dylanballback/CubeSat_Attitude_Control/README.md

# CubeSat Attitude Control Testbed
### Goals
Development of a 1U CubeSat Reaction Wheel Attitude Control Testbed that can be acessed through a website where anyone can upload code for tesing their control algorithm and view a live stream of their controls algorithm on hardware in real time.

---

# Major Milestones
### Controls of Reaction Wheel
| Milestone | Date Completed |
| --- | ---
| Create 1 DoF with 1 reaction wheel able to balance itself using a PID controller | 
| Create 2 DoF with 2 reaction wheels able to balance itself using a PID controller | 
| Create 3 DoF with 3 reaction wheels able to balance itself using a PID controller | 
| Create a 3 DoF reaction wheel controller able to reach any desired attitude using a PID controller |

### CubeSat Hardware
| Milestone | Date Completed |
| --- | ---
| Prototype CAD Assembly of 1U CubeSat with 3 Reaction wheels, IMU, Arduino, Raspberry Pi Zero, and Battery | 
| 3D print and assemble prototype 1U CubeSat will all componets mounted inside |
| Final CAD Assembly of 1U CubeSat with 3 Reaction wheels, IMU, Arduino, Raspberry Pi Zero, and Battery |
| 3D print and assemble final 1U CubeSat will all componets mounted inside | 

### Gimbal/Test Stand
| Milestone | Date Completed |
| --- | ---
| Prototype CAD Assembly of all three gimbal rings with mounting mounts to eachother and to the CubeSat | 
| 3D print prototype and assemble all 3 gimbal rings | 
| Attaching Gimbal test stand to 80/20 mounting frame |
| Final CAD Assembly of all three gimbal rings with mounting mounts to eachother and to the CubeSat |  

### Software
| Milestone | Date Completed |
| --- | ---
| All Arduino functions complete and rigiously tested |
| All Raspberry Pi functions complete and rigiously tested | 
| Raspberry Pi connected to webserver and able to upload code wirelessly |

### Integration 
| Milestone | Date Completed |
| --- | ---
| Attaching 1U CubeSat into gimbal rings  |
| Uploading code through website successfully  |

### Research Paper 
| Milestone | Date Completed |
| --- | ---
| Create Outline |
| Complete Rough Draft |
| Complete Final Version |
| Publish Research Paper |

---

# Schedule
| Due By Date | Milestone | Completed | Class Assignment
--- | --- | --- | ---
| 2/13/22 | ~~Project Proposal~~ | 2/13/22 | Yes
| 2/27/22 | 1 DoF reaction wheel balance with PID |   |
| 2/27/22 | Prototype CAD assembly of 1U CubeSat |   |
| 2/27/22 | Prototype CAD assembly of Gimbal testbed |   |
| 2/27/22 | Research Paper Outline | 
| 2/27/22 | Research Reduction |   | Yes
| 3/14/22 | 3D Print prototype 1U CubeSat and assemble  |    | 
| 3/14/22 | 3D Print prototype gimbal and assemble  |    |
| 3/14/22 | All Arduino functions complete and rigiously tested  |    |
| 3/14/22 | 2 DoF reaction wheel balance PID  |    |
| 3/21/22 | All Raspberry Pi functions complete and rigiously tested |    |
| 3/21/22 | Reserch paper rough draft |    |
| 3/21/22 | Project Update |    | Yes
| 4/10/22 | 3 DoF reaction wheel balance PID|    |
| 4/10/22 | Final CAD assembly of 1U CubeSat  |    |
| 4/10/22 | Prototype CAD assembly of gimbal testbed |    |
| 3/17/22 | 3D Print final 1U CubeSat and assemble  |    | 
| 3/17/22 | 3D Print final gimbal and assemble  |    |
| 4/17/22 | 1U CubeSat mounted in Gimbal |    |
| 4/24/22 | Wireless code upload |    |
| 4/24/22 | Research Paper Final Version |    |
| 5/1/22 | 3 DoF Attitude PID Controller |   | 
| 5/1/22 | Project Presentation |   | Yes
| 5/2/22 | Publish Research Paper |   | 
| 5/2/22 | Project Technical Paper |   | Yes

---

# Budget
| Item | Description | Link | Quantity | Cost/Item | Total Cost
--- | --- | --- | --- | --- | ---
| BLDC Motor | Reaction wheel motor | [Link](https://www.ebay.com/itm/264321073124) | 3 | $20 | $60
| MPU 6050 | IMU Sensor | [Link](https://www.amazon.com/HiLetgo-MPU-6050-Accelerometer-Gyroscope-Converter/dp/B01DK83ZYQ?th=1) | 1 | $6 | $6
| Photoresistor | Mock "Solar Sensor" | [Link](https://www.adafruit.com/product/161) | 6 | $1 | $6
| Raspberry Pi Zero 2 W | Mini Computer | [Link](https://www.canakit.com/raspberry-pi-zero-2-w.html) | 1 | $15 | $15
| Arduino Nano | Microcontroller | [Link](https://www.amazon.com/ELEGOO-Arduino-ATmega328P-Without-Compatible/dp/B0713XK923) | 1 | $8 | $8
| PLA | 3D printer material | [Link](https://www.amazon.com/HATCHBOX-3D-Filament-Dimensional-Accuracy/dp/B00J0ECR5I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) | 1 | $22 | $22
| Low Friction Bearings | Gimbal bearings | [Link](https://www.amazon.com/s?k=Low+Friction+Bearings&rh=n%3A16410991&ref=nb_sb_noss) | 10 | $1 | $10
| Batteries | 18650 cells | [Link](https://www.18650batterystore.com/) | 6 | $5 | $30
| Battery Management System | Protect batteries | Custom | 1 | $15 | $15
| | | | | | $172
