dylanballback/CubeSat_Attitude_Control/Hardware/Gimbal Hardware/README.md

# Gimbal test bed stand for CubeSat Hardware

## Goals
The goal of the gimbal is to design and build a system that a 1U CubeSat mounts inside and provide free rotations in 3 degrees of freedom. This test stand gimbal will allow for the 1U CubeSat to freely rotate in all 3 DoF for testing the attitude control using 3 reaction wheels.

## To-Do

### Gimbal CAD
| Declared | To-Do | Completed |
--- | --- | ---
| 2/8/22 | ~Design mounting mechanism to attach the 1U CubeSat to the inner ring~ | 2/20/22
| 2/8/22 | ~3D print and test fitment of CubeSat connection to inner ring~ | 2/20/22
| 2/8/22 | ~Calculate and design the 3 gimbal rings~ | 2/20/22
| 2/8/22 | ~3D print and test fitment of the 3 rings and connection~ | 2/26/22
| 2/8/22 | ~Test fitment of bearing componets into 3D printed ring and connection between the rings~ | 2/26/22
| 2/8/22 | ~Design outter ring external mounting points to be compatiable to monut to a 80/20 test stand~ | 2/27/22
| 2/8/22 | ~Build 80/20 Gimbal Test stand~ | 2/27/22
| 2/8/22 | ~Assembly and mount all componets of the gimbal and cubesat into the test stand~ | 2/27/22
| 2/8/22 | Optimize ring componet fitment and connections |

### Gimbal Hardware
| Declared | To-Do | Completed |
--- | --- | ---
| 2/8/22 | Figure out the best bearings for the gimbal to allow for low friction rotation |

## Updates 

### 2/20/22
- Designed prototype gimbal rings.
<p>
    
</p>

---

### 2/26/22
- 3D printed prototype gimbal ring, testing bearings and fitment of componets and connectors.
<p>
    
    
</p>

---

### 2/27/22
- Designed and built CubeSat gimbal teststand, and 3D printed peices.
<p float="center">
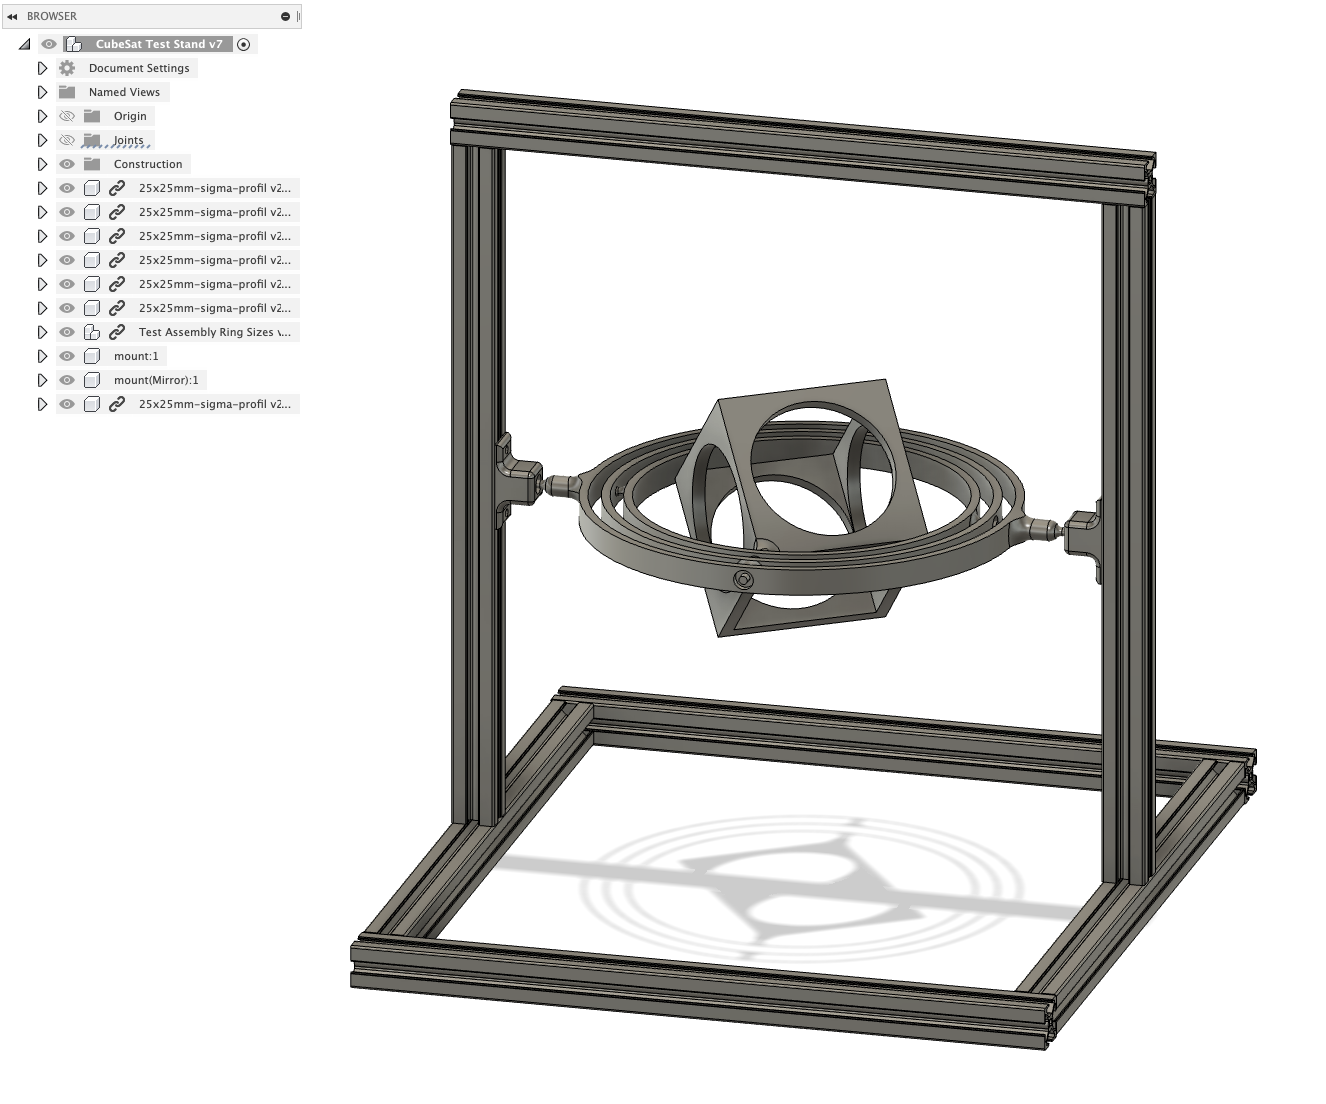
[picture p15: Images/cubesat_hardware/cubesat_testbed_v1cad.png]
    
</p>
<p float="left">
    
    
</p>

---

### 2/28/22 
- Optmizing CAD for press fitment of the bearings and ring connections

<p>
    
</p>

---

### 3/3/22 
- Updated gimbal mounts to CubeSat frame using threaded inserts on the side frame of the CubeSat instead previously where I was mounting it from corners. Using this method will allow for the CubeSat frame itself will be easier to 3D print and rapidly iterated upon and not require new print everytime to mount to the gimbal. 

<p>
    
    
    
    
</p>

---

### 3/4/22
- Designed and 3D printed a gimbal lock piece that snaps in place to lock the gimbal rings in place, this will allow for me to test the reaction wheel PID control of just a single axis in the gimbal mount. 

<p>
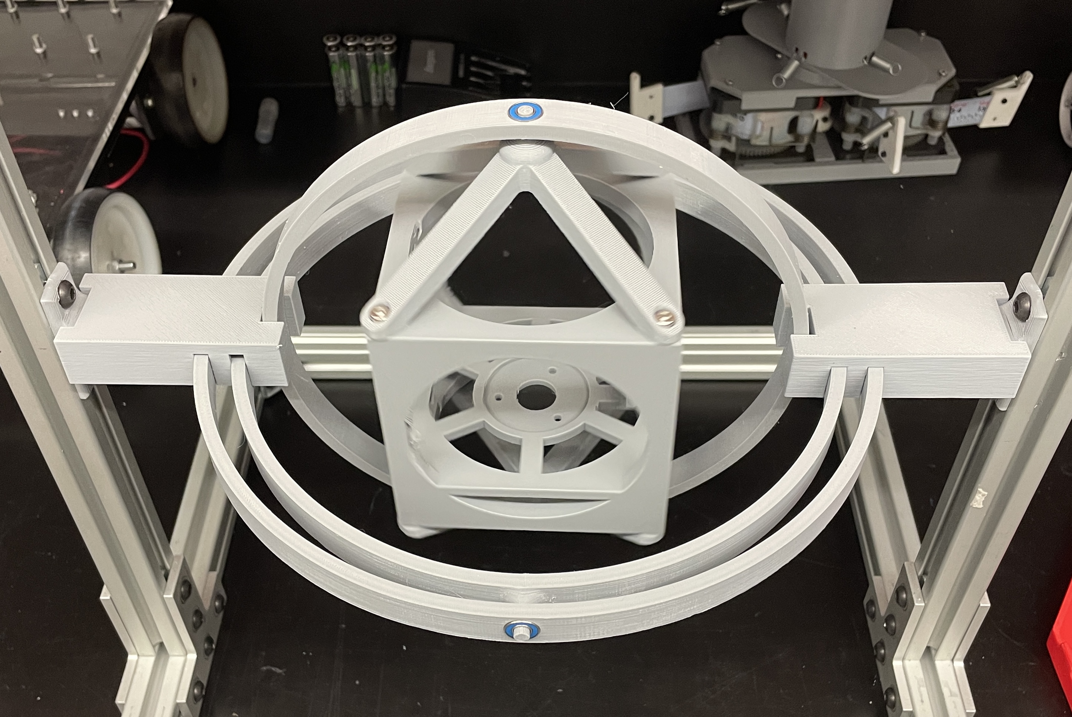
[picture p19: Images/cubesat_hardware/front_1dof_gimballock.JPG]
    
    
    
</p>
