dylanballback/CubeSat_Attitude_Control/Software/Wireless Communincation/Raspberry Pi & Arduino Com/Serial Communication/README.md

# Serial communication between Arduino and Computer

This is a simple test of how to recive usable data from serial in python from an Arduino 

- The arduino code is just printing to serial monitor
- The python code is reading the serial data and decoding it to print as a string
