dylanballback/CubeSat_Attitude_Control/Papers and Posters/Discovery_Day_Poster_4_6_22.pptx

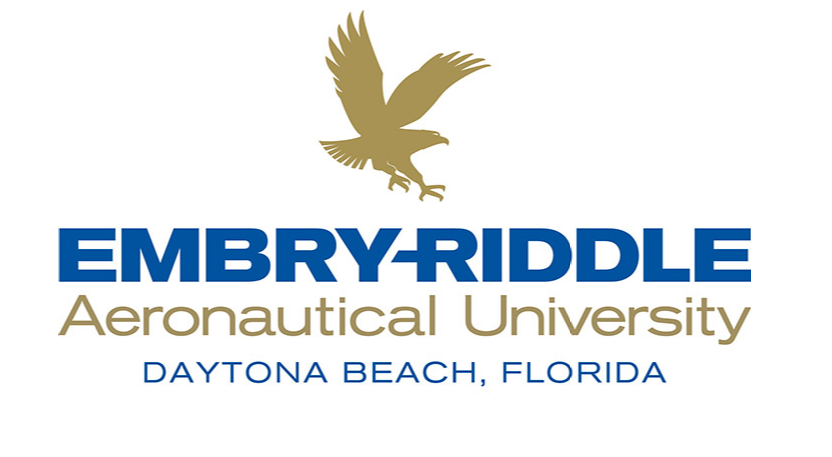
[picture p23: figure]

CubeSat Reaction Wheel
Attitude Control Platform

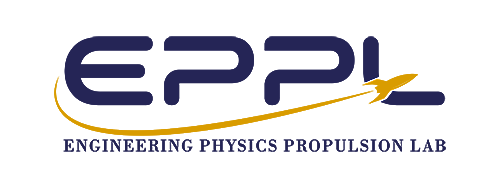
[picture p24: figure]
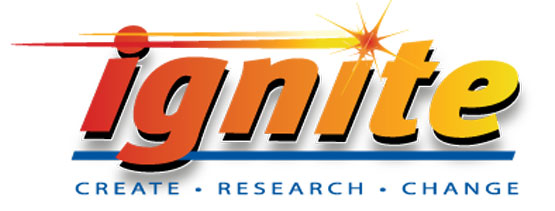
[picture p25: figure]

Dylan Ballback, Daniel Wilczak, Justin Hartland, Ella Cheatham, Daniel Golan

Abstract

- In the classroom, learning the math behind spacecraft attitude control is math-intensive. It is common that students struggle to develop the connection between the math they are learning and visualizing how it could be applied to a real-world application.
- The goal of this project is to design and manufacture a 1U, 3U, 6U CubeSat testbed for autonomous control systems utilizing reaction wheels. The testbed will include three separate reaction wheels each mounted on its own respected axis of the rotation plane to control the attitude in 3 degrees of freedom.
- The end goal of the CubeSat testbed is to be integrated into a website where anyone online can upload their own controls algorithm and watch a live stream of how their algorithm performs on hardware in real-time.

Significance

1. The current process to learn CubeSat controls is vastly conceptual for students from the high school, undergraduate, and even graduate levels.
2. Building a testbed in a gimbal connected to the internet would allow students the opportunity to test their designs, theories, and software on real CubeSat hardware in real-time.
3. A use case for the testbed would be to integrate into the classroom while learning the math behind attitude controls.

- Project Goals

- Develop a 1U, 3U, and 6U CubeSat Reaction Wheel Attitude Control Platform.
- Integrate CubeSat control into a website to allow anyone to upload their own control algorithm and watch a live stream to evaluate how it performs.

- Current State

- Prototype 1U CubeSat 3D printed and assembled.
- Designed and assembled 1U CubeSat gimbal rings and test stand.
- Achieved simple 1 degree of freedom PID controller.
- Accomplished basic WebSocket wireless communication infrastructure between the CubeSat and a website to live stream data in real-time and send data from website.

CubeSat attitude control is to enable the CubeSat to point in the desired direction that is set in relation to a reference frame.

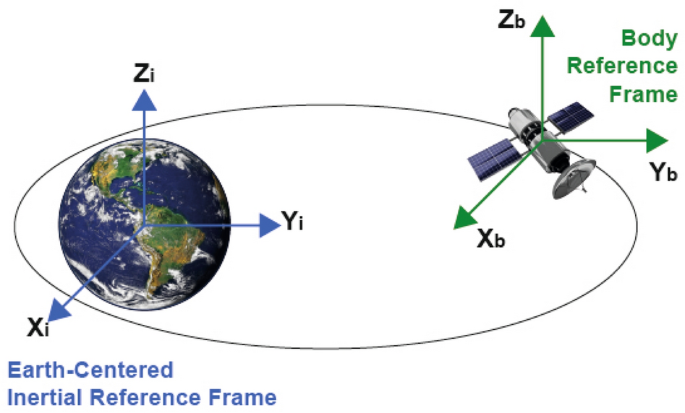
[picture p26: figure]
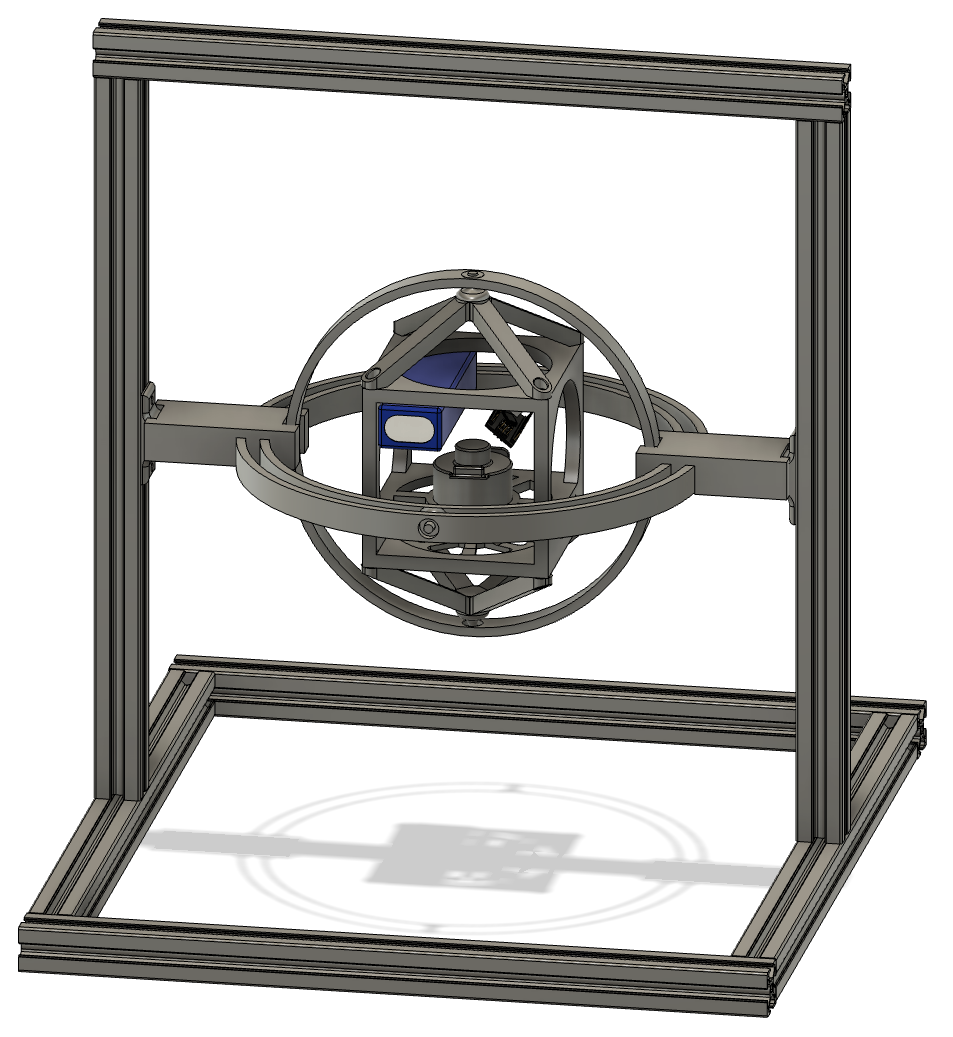
[picture p27: figure]
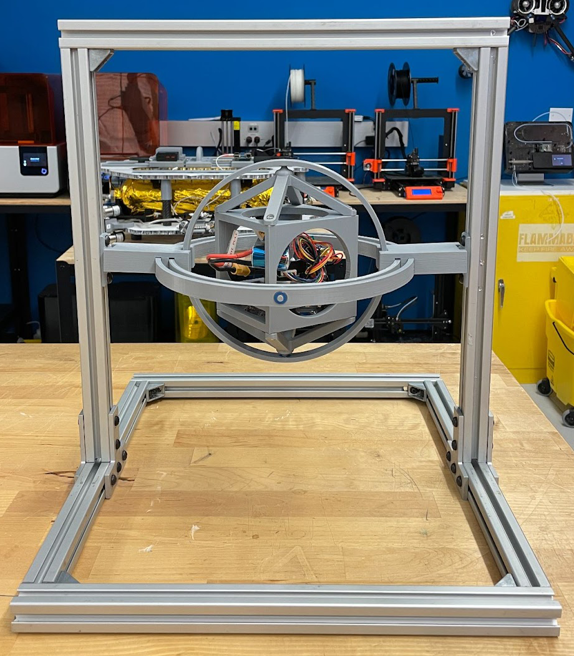
[picture p28: figure]
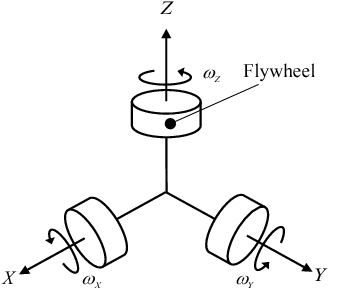
[picture p29: figure]

- Methodology

- Design and 3D print a 1U, 3U, and 6U CubeSat test bed.
- Design and 3D print the 1U, 3U, and 6U gimbal ring assembly to allow for free rotation in 3 degrees of freedom.
- Design and fabricate extruded aluminum test stand to hold gimbal and CubeSat assembly for 1U, 3U, and 6U CubeSat.
- Develop the electronics/software to control reaction wheel motors and read IMU and motor encoder sensors.
- Develop software infrastructure for wireless communication between website and CubeSat.
- Develop example PID controller to control CubeSat attitude.

Moving Forward

- Working on design and 3D printing of the first prototype of the 3U and 6U CubeSat for 1 DOF control testing.
- Developing design and assembly for 3U and 6U CubeSat gimbal rings and test stand.

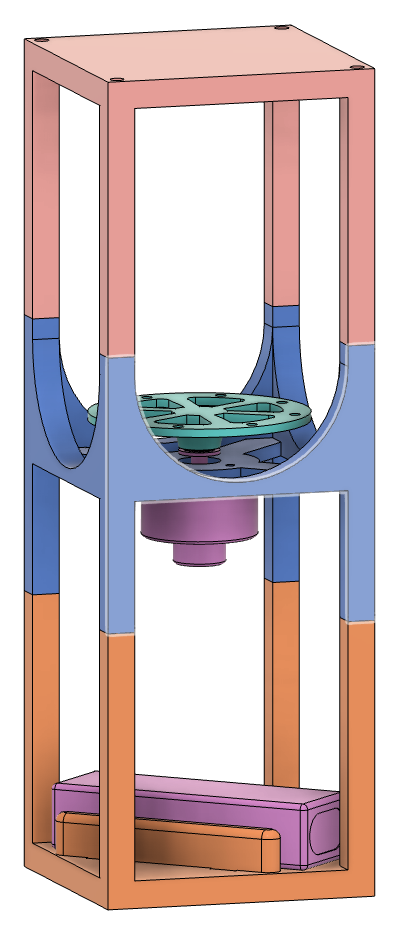
[picture p30: figure]

3U CubeSat CAD Prototype

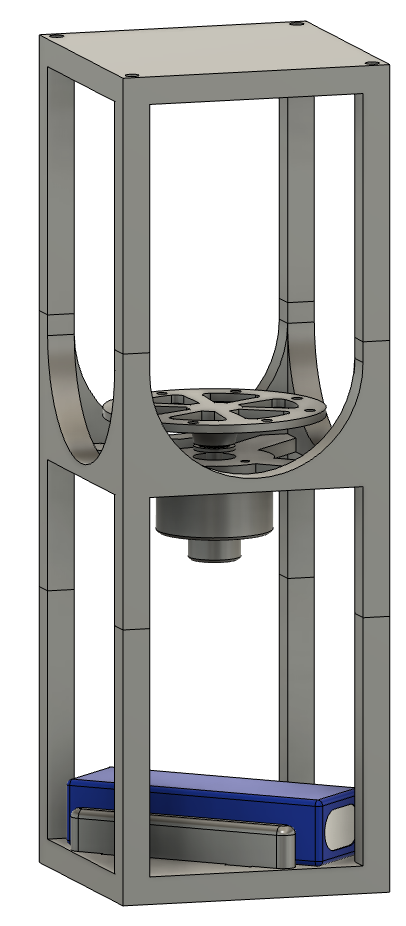
[picture p31: figure]
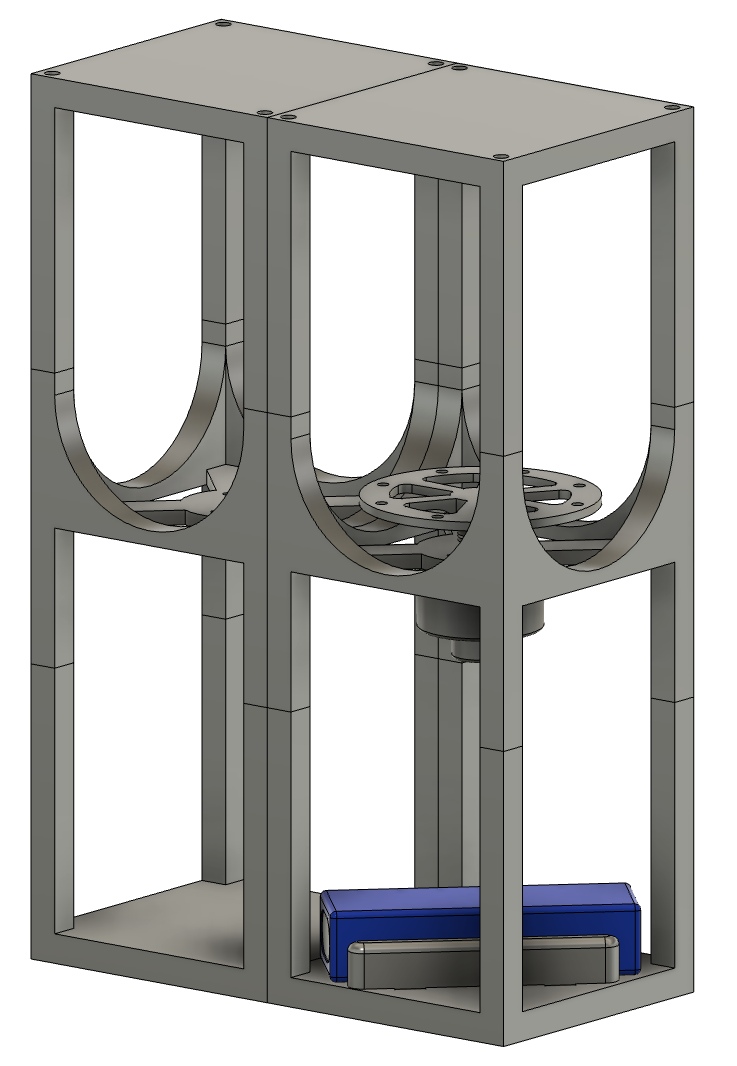
[picture p32: figure]

6U CubeSat CAD Prototype

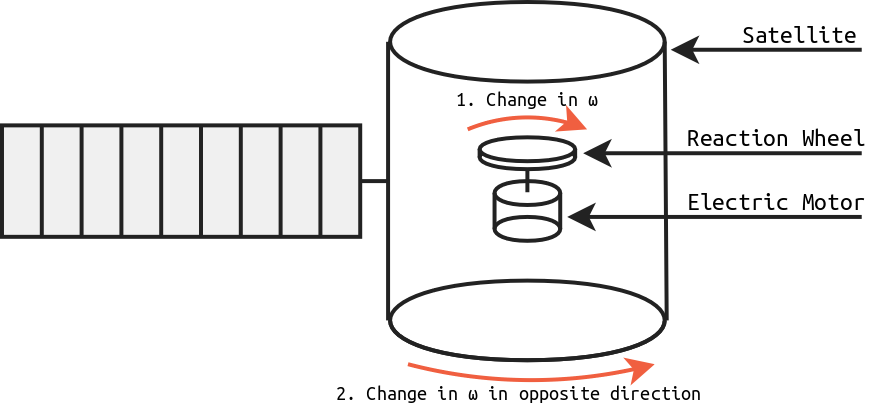
[picture p33: figure]
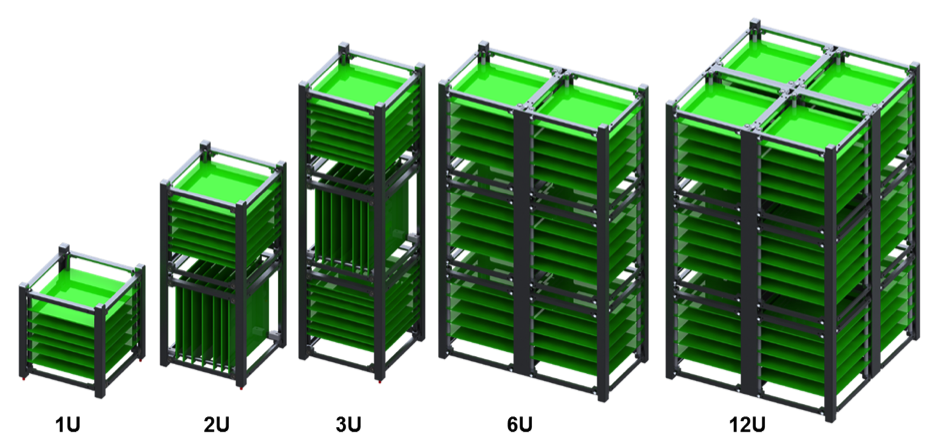
[picture p34: figure]

Notes: To change this poster, replace our sample content with your own. Or, if you'd rather start from a clean slate, use the New Slide button on the Home tab to insert a new page, then enter your text and content in the empty placeholders. If you need more placeholders for titles, subtitles or body text, copy any of the existing placeholders, then drag the new one into place.
