dylanballback/CubeSat_Attitude_Control/Images/CubeSat_control_PCB2022-04-10 at 11.04.40 PM.png

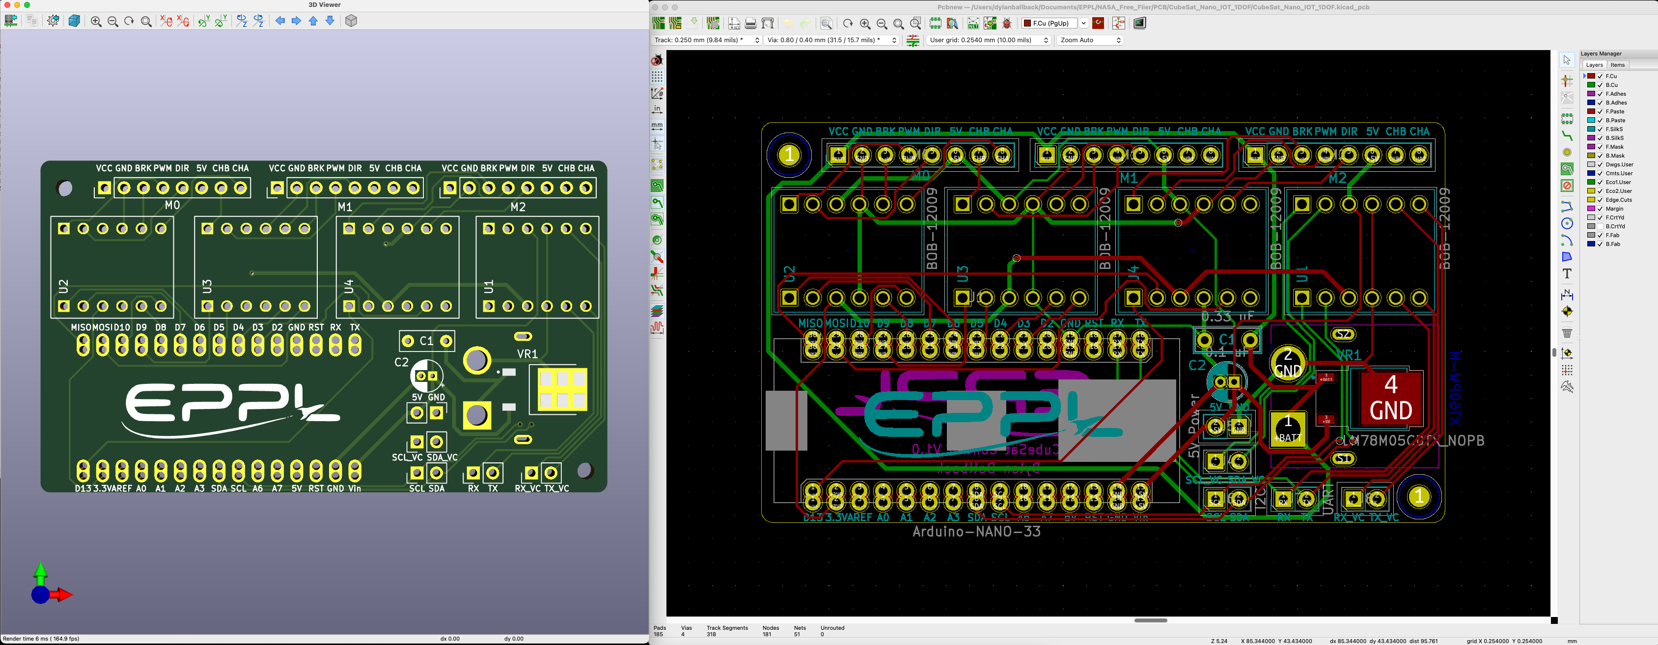
Images/CubeSat_control_PCB2022-04-10 at 11.04.40 PM.png
