dylanballback/CubeSat_Attitude_Control/(list of files, cad)

Other CAD files:
Hardware/Gimbal Hardware/Gimbal CAD V1/1U CubeSat v5.ipt
