dylanballback/CubeSat_Attitude_Control/1DoF Prototype/Arduino/balance_V14/balance_V14.ino

#include <Kalman.h> // Source: https://github.com/TKJElectronics/KalmanFilter
#include <Wire.h>        // IIC communication library
#include <PWM.h>        // Require Timer1 PWM frequency of 20Khz-25Khz for Nidec 24H677 BLDC Motor
#include "QuickPID.h"

//Cite http://brettbeauregard.com/blog/2011/04/improving-the-beginner%E2%80%99s-pid-reset-windup/)

//---------------------------------------- Nidec 24H677H010 BLDC Motor Vars START ------------------------------------
const int nidecBrake = 8;      // Brake
const int nidecDirection = 7;  // CW/CCW Nidec Motor
const int ledsDirection = 6;   // Green LED direction indicators
const int ledsBrake = 5;       // Red LED direction indicators
const int nidecPWM = 9;        // Nidec Motor PWM
int brake_trigger = 1;         //Brake is ON
int dir = 0;                   //Direction set to CCW
double pwm = 400;              // Set pwm value to 400 = motor stopped
//---------------------------------------- Nidec 24H677H010 BLDC Motor Vars END --------------------------------------


//---------------------------------------- Kalman Filter START -------------------------------------------------------
#define RESTRICT_PITCH // Comment out to restrict roll to ±90deg instead - please read: http://www.freescale.com/files/sensors/doc/app_note/AN3461.pdf

Kalman kalmanX; // Create the Kalman instances
Kalman kalmanY;

/* IMU Data */
double accX, accY, accZ;
double gyroX, gyroY, gyroZ;
int16_t tempRaw;

double gyroXangle, gyroYangle; // Angle calculate using the gyro only
double compAngleX, compAngleY; // Calculated angle using a complementary filter
double kalAngleX, kalAngleY; // Calculated angle using a Kalman filter

uint32_t timer;
uint8_t i2cData[14]; // Buffer for I2C data
//---------------------------------------- Kalman Filter END -------------------------------------------------------



//---------------------------------------- PID Vars START -------------------------------------------------------
/*
//PID constants
double kp = 10;
double ki = 0.05;
double kd = 0;

double outMin = -400;
double outMax = 400;


int term;
 
unsigned long currentTime, previousTime;
double elapsedTime;
double error;
double lastError;
double Input, Output, Setpoint;
double i, d;
*/
double bounds = 0.3;
//---------------------------------------- PID Vars END -----------------------------------------------------------
//Define Variables we'll be connecting to
float Setpoint, Input, Output;

//Define the aggressive and conservative and POn Tuning Parameters
float aggKp = 8, aggKi = 0.2, aggKd = 1;
float consKp = 2, consKi = 0.05, consKd = 0.5;

//Specify the links
QuickPID myPID(&Input, &Output, &Setpoint);



//%%%%%%%%%%%%%%%%%%%%%%%%%%%%%%%%%%%%%%%%%%%%%%%%%%%%%%%%%%%%%%%%%%%%%%%%%%%%%%%%%%%%%%%%%%%%%%%%%%%%%%%%%%%%%%%%%%%%%%
//%%%%%%%%%%%%%%%%%%%%%%%%%%%%%%%%%%%%%%%%%%%%%%%% Setup Function Start %%%%%%%%%%%%%%%%%%%%%%%%%%%%%%%%%%%%%%%%%%%%%%%%
//%%%%%%%%%%%%%%%%%%%%%%%%%%%%%%%%%%%%%%%%%%%%%%%%%%%%%%%%%%%%%%%%%%%%%%%%%%%%%%%%%%%%%%%%%%%%%%%%%%%%%%%%%%%%%%%%%%%%%%
void setup() {
  
  // PWM.h Setup
  InitTimersSafe();
  // The Nidec 24H677 BLDC Motor requires a PWM frequency of 20KHz to 25KHz
  bool success = SetPinFrequencySafe(nidecPWM, 20000);

  //set the Nidec motor control pins 
  pinMode(nidecBrake, OUTPUT);
  pinMode(nidecDirection,OUTPUT);
  pinMode(ledsDirection,OUTPUT);
  pinMode(ledsBrake,OUTPUT);
  pinMode(nidecPWM,OUTPUT);
  
  // Output initial state values
  digitalWrite(nidecDirection,LOW); // Nidec Direction CCW
  digitalWrite(ledsDirection,LOW); //Green LED OFF // Direction CCW
  digitalWrite(nidecBrake,LOW); // Nidec motor brake is ON
  digitalWrite(ledsBrake,HIGH); //Red LED ON // Brake ON

  
//---------------------------------------- Kalman Filter START -------------------------------------------------------
  Serial.begin(115200);
  Wire.begin();
  #if ARDUINO >= 157
    Wire.setClock(400000UL); // Set I2C frequency to 400kHz
  #else
    TWBR = ((F_CPU / 400000UL) - 16) / 2; // Set I2C frequency to 400kHz
  #endif

  i2cData[0] = 7; // Set the sample rate to 1000Hz - 8kHz/(7+1) = 1000Hz
  i2cData[1] = 0x00; // Disable FSYNC and set 260 Hz Acc filtering, 256 Hz Gyro filtering, 8 KHz sampling
  i2cData[2] = 0x00; // Set Gyro Full Scale Range to ±250deg/s
  i2cData[3] = 0x00; // Set Accelerometer Full Scale Range to ±2g
  while (i2cWrite(0x19, i2cData, 4, false)); // Write to all four registers at once
  while (i2cWrite(0x6B, 0x01, true)); // PLL with X axis gyroscope reference and disable sleep mode

  while (i2cRead(0x75, i2cData, 1));
  if (i2cData[0] != 0x68) { // Read "WHO_AM_I" register
    Serial.print(F("Error reading sensor"));
    while (1);
  }

  delay(100); // Wait for sensor to stabilize

  /* Set kalman and gyro starting angle */
  while (i2cRead(0x3B, i2cData, 6));
  accX = (int16_t)((i2cData[0] << 8) | i2cData[1]);
  accY = (int16_t)((i2cData[2] << 8) | i2cData[3]);
  accZ = (int16_t)((i2cData[4] << 8) | i2cData[5]);

  // Source: http://www.freescale.com/files/sensors/doc/app_note/AN3461.pdf eq. 25 and eq. 26
  // atan2 outputs the value of -π to π (radians) - see http://en.wikipedia.org/wiki/Atan2
  // It is then converted from radians to degrees
  #ifdef RESTRICT_PITCH // Eq. 25 and 26
    double roll  = atan2(accY, accZ) * RAD_TO_DEG;
    double pitch = atan(-accX / sqrt(accY * accY + accZ * accZ)) * RAD_TO_DEG;
  #else // Eq. 28 and 29
    double roll  = atan(accY / sqrt(accX * accX + accZ * accZ)) * RAD_TO_DEG;
    double pitch = atan2(-accX, accZ) * RAD_TO_DEG;
  #endif

  kalmanX.setAngle(roll); // Set starting angle
  kalmanY.setAngle(pitch);
  gyroXangle = roll;
  gyroYangle = pitch;
  compAngleX = roll;
  compAngleY = pitch;
//------------------------------------------------ Kalman Filter END --------------------------------------------------------
  myPID.SetOutputLimits(0, 400);
  Setpoint = 0;                          //set point at zero degrees
 //turn the PID on
  myPID.SetMode(myPID.Control::automatic);
}
//%%%%%%%%%%%%%%%%%%%%%%%%%%%%%%%%%%%%%%%%%%%%%%%%%%%%%%%%%%%%%%%%%%%%%%%%%%%%%%%%%%%%%%%%%%%%%%%%%%%%%%%%%%%%%%%%%%%%%%
//%%%%%%%%%%%%%%%%%%%%%%%%%%%%%%%%%%%%%%%%%%%%%% Setup Function END %%%%%%%%%%%%%%%%%%%%%%%%%%%%%%%%%%%%%%%%%%%%%%%%%%%%
//%%%%%%%%%%%%%%%%%%%%%%%%%%%%%%%%%%%%%%%%%%%%%%%%%%%%%%%%%%%%%%%%%%%%%%%%%%%%%%%%%%%%%%%%%%%%%%%%%%%%%%%%%%%%%%%%%%%%%%


//%%%%%%%%%%%%%%%%%%%%%%%%%%%%%%%%%%%%%%%%%%%%%%%%%%%%%%%%%%%%%%%%%%%%%%%%%%%%%%%%%%%%%%%%%%%%%%%%%%%%%%%%%%%%%%%%%%%%%%
//%%%%%%%%%%%%%%%%%%%%%%%%%%%%%%%%%%%%%%%%%%%%%% Loop Function START %%%%%%%%%%%%%%%%%%%%%%%%%%%%%%%%%%%%%%%%%%%%%%%%%%%
//%%%%%%%%%%%%%%%%%%%%%%%%%%%%%%%%%%%%%%%%%%%%%%%%%%%%%%%%%%%%%%%%%%%%%%%%%%%%%%%%%%%%%%%%%%%%%%%%%%%%%%%%%%%%%%%%%%%%%%
void loop() {
 
  double x_angle = kalman();

 
  Input = x_angle;


  /*
  //Calculate the PID output
  Output = computePID(Input, x_angle);
  
    //Switches the direction of the wheel based on sign of PID output
  if (Output > 1){
    dir = 1; //CW
    Output = map(Output, 0, outMax, 0, 400);
    //This is just fliping the PWM value from 0 to 390 ---> to 390 to 0
    //Whereas 0 = stopped and 390 = full speed
    pwm = map(Output, 0, outMax, 400, 0);
    //Serial.print("dir: ");
    //Serial.print("CW");
    //Serial.print("    ");
  }
  else if (Output < 0){
    dir = 0; //CCW
    Output = abs(Output);
    Output = map(Output, 0, outMin, 0, 400);
    //This is just fliping the PWM value from -390 to 0 ---> to 390 to 0
    //Whereas 0 = stopped and 390 = full speed
    pwm = map(Output, 0, outMin, 400, 0);
    //Serial.print("dir: ");
    //Serial.print("CCW");
    //Serial.print("    ");
  }
  */

  if (x_angle > -bounds && x_angle < bounds){
    pwm = 400;
  }


  float gap = abs(Setpoint - Input); //distance away from setpoint
  if (gap < 10) { //we're close to setpoint, use conservative tuning parameters
    myPID.SetTunings(consKp, consKi, consKd);
  } else {
    //we're far from setpoint, use aggressive tuning parameters
    myPID.SetTunings(aggKp, aggKi, aggKd);
  }
  myPID.Compute();
  pwm = map(Output, 0, 400, 400, 0);
  //This is the comand to drive the motor
  driveMotor(pwm, dir);
  Serial.println(pwm);
  

}//end of loop void
//%%%%%%%%%%%%%%%%%%%%%%%%%%%%%%%%%%%%%%%%%%%%%%%%%%%%%%%%%%%%%%%%%%%%%%%%%%%%%%%%%%%%%%%%%%%%%%%%%%%%%%%%%%%%%%%%%%%%%%
//%%%%%%%%%%%%%%%%%%%%%%%%%%%%%%%%%%%%%%%%%%%%%% Loop Function END %%%%%%%%%%%%%%%%%%%%%%%%%%%%%%%%%%%%%%%%%%%%%%%%%%%
//%%%%%%%%%%%%%%%%%%%%%%%%%%%%%%%%%%%%%%%%%%%%%%%%%%%%%%%%%%%%%%%%%%%%%%%%%%%%%%%%%%%%%%%%%%%%%%%%%%%%%%%%%%%%%%%%%%%%%%



//$$$$$$$$$$$$$$$$$$$$$$$$$$$$$$$$$$$$$$  Kalman Filter Function START $$$$$$$$$$$$$$$$$$$$$$$$$$$$$$$$$$$$$$
double kalman(){
  /* Update all the values */
  while (i2cRead(0x3B, i2cData, 14));
  accX = (int16_t)((i2cData[0] << 8) | i2cData[1]);
  accY = (int16_t)((i2cData[2] << 8) | i2cData[3]);
  accZ = (int16_t)((i2cData[4] << 8) | i2cData[5]);
  tempRaw = (int16_t)((i2cData[6] << 8) | i2cData[7]);
  gyroX = (int16_t)((i2cData[8] << 8) | i2cData[9]);
  gyroY = (int16_t)((i2cData[10] << 8) | i2cData[11]);
  gyroZ = (int16_t)((i2cData[12] << 8) | i2cData[13]);;

  double dt = (double)(micros() - timer) / 1000000; // Calculate delta time
  timer = micros();

  // Source: http://www.freescale.com/files/sensors/doc/app_note/AN3461.pdf eq. 25 and eq. 26
  // atan2 outputs the value of -π to π (radians) - see http://en.wikipedia.org/wiki/Atan2
  // It is then converted from radians to degrees
#ifdef RESTRICT_PITCH // Eq. 25 and 26
  double roll  = atan2(accY, accZ) * RAD_TO_DEG;
  double pitch = atan(-accX / sqrt(accY * accY + accZ * accZ)) * RAD_TO_DEG;
#else // Eq. 28 and 29
  double roll  = atan(accY / sqrt(accX * accX + accZ * accZ)) * RAD_TO_DEG;
  double pitch = atan2(-accX, accZ) * RAD_TO_DEG;
#endif

  double gyroXrate = gyroX / 131.0; // Convert to deg/s
  double gyroYrate = gyroY / 131.0; // Convert to deg/s

#ifdef RESTRICT_PITCH
  // This fixes the transition problem when the accelerometer angle jumps between -180 and 180 degrees
  if ((roll < -90 && kalAngleX > 90) || (roll > 90 && kalAngleX < -90)) {
    kalmanX.setAngle(roll);
    compAngleX = roll;
    kalAngleX = roll;
    gyroXangle = roll;
  } else
    kalAngleX = kalmanX.getAngle(roll, gyroXrate, dt); // Calculate the angle using a Kalman filter

  if (abs(kalAngleX) > 90)
    gyroYrate = -gyroYrate; // Invert rate, so it fits the restriced accelerometer reading
  kalAngleY = kalmanY.getAngle(pitch, gyroYrate, dt);
#else
  // This fixes the transition problem when the accelerometer angle jumps between -180 and 180 degrees
  if ((pitch < -90 && kalAngleY > 90) || (pitch > 90 && kalAngleY < -90)) {
    kalmanY.setAngle(pitch);
    compAngleY = pitch;
    kalAngleY = pitch;
    gyroYangle = pitch;
  } else
    kalAngleY = kalmanY.getAngle(pitch, gyroYrate, dt); // Calculate the angle using a Kalman filter

  if (abs(kalAngleY) > 90)
    gyroXrate = -gyroXrate; // Invert rate, so it fits the restriced accelerometer reading
  kalAngleX = kalmanX.getAngle(roll, gyroXrate, dt); // Calculate the angle using a Kalman filter
#endif

  gyroXangle += gyroXrate * dt; // Calculate gyro angle without any filter
  gyroYangle += gyroYrate * dt;
  //gyroXangle += kalmanX.getRate() * dt; // Calculate gyro angle using the unbiased rate
  //gyroYangle += kalmanY.getRate() * dt;

  compAngleX = 0.93 * (compAngleX + gyroXrate * dt) + 0.07 * roll; // Calculate the angle using a Complimentary filter
  compAngleY = 0.93 * (compAngleY + gyroYrate * dt) + 0.07 * pitch;

  // Reset the gyro angle when it has drifted too much
  if (gyroXangle < -180 || gyroXangle > 180)
    gyroXangle = kalAngleX;
  if (gyroYangle < -180 || gyroYangle > 180)
    gyroYangle = kalAngleY;
      
  //Serial.print(kalAngleX);
  //Serial.print('\n');
  return kalAngleX;
}
//$$$$$$$$$$$$$$$$$$$$$$$$$$$$$$$$$$$$$$  Kalman Filter Function END $$$$$$$$$$$$$$$$$$$$$$$$$$$$$$$$$$$$$$



//$$$$$$$$$$$$$$$$$$$$$$$$$$$$$$$$$$$$$$  Drive Motor Function START $$$$$$$$$$$$$$$$$$$$$$$$$$$$$$$$$$$$$$
// For pwm: 400 = stopped and 0 = full speed
// For dir: 0 = CCW and 1 = CW
void driveMotor(float pwm,int dir){
  //if pwm 
  digitalWrite(nidecBrake,HIGH);    // Nidec motor brake OFF
  digitalWrite(ledsBrake,LOW);      //Red LED OFF // Brake OFF
  if(dir == 0){
    analogWrite(nidecPWM, pwm);
    digitalWrite(nidecDirection,LOW); // Nidec Direction CCW
    digitalWrite(ledsDirection,LOW);  //Green LED OFF // Direction CCW
    }
  else if(dir == 1){
    analogWrite(nidecPWM, pwm);
    digitalWrite(nidecDirection,HIGH); // Nidec Direction CW
    digitalWrite(ledsDirection,HIGH);  //Green LED ON // Direction CW
    } 
}
//$$$$$$$$$$$$$$$$$$$$$$$$$$$$$$$$$$$$$$  Drive Motor Function END $$$$$$$$$$$$$$$$$$$$$$$$$$$$$$$$$$$$$$$$$
