dylanballback/CubeSat_Attitude_Control/Software/Arduino/main/photoresister.h

//#pragma once
//
//void read_photo()
//{
//  int photor1 = analogRead(A3);
//  int photor4 = analogRead(A6);
//
//  float pr1 = photor1 * (3.3 / 1023.0);
//  float pr4 = photor4 * (3.3 / 1023.0);
//
//  sensor_data.photo1 = pr1;
//  sensor_data.photo2 = pr4;
//
//}
////Photoresiter Data Collection
//int photor1 = analogRead(A3);
//int photor2 = analogRead(A4);
//int photor3 = analogRead(A5);
//int photor4 = analogRead(A6);
//  
//float pr1 = photor1 * (3.3 / 1023.0);
//float pr2 = photor2 * (3.3 / 1023.0);
//float pr3 = photor3 * (3.3 / 1023.0);
//float pr4 = photor4 * (3.3 / 1023.0);
