dylanballback/CubeSat_Attitude_Control/Software/Arduino/Testing_WiFiWebServer_V1/Testing_WiFiWebServer_V1.ino

/****************************************************************************************************************************
  WiFiWebServer.ino

  A simple web server that shows the value of the analog input pins.

  This example is written for a network using WPA encryption. For
  WEP or WPA, change the Wifi.begin() call accordingly.

  Circuit:
   Analog inputs attached to pins A0 through A5 (optional)

  created 13 July 2010
  by dlf (Metodo2 srl)
  modified 31 May 2012
  by Tom Igoe

  Based on and modified from WiFiNINA library https://www.arduino.cc/en/Reference/WiFiNINA
  to support nRF52, SAMD21/SAMD51, STM32F/L/H/G/WB/MP1, Teensy, etc. boards besides Nano-33 IoT, MKRWIFI1010, MKRVIDOR400, etc.

  Built by Khoi Hoang https://github.com/khoih-prog/WiFiNINA_Generic
  Licensed under MIT license

  Copyright (c) 2018 Arduino SA. All rights reserved.
  Copyright (c) 2011-2014 Arduino LLC.  All right reserved.

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
  You should have received a copy of the GNU Lesser General Public
  License along with this library; if not, write to the Free Software
  Foundation, Inc., 51 Franklin St, Fifth Floor, Boston, MA  02110-1301  USA
 *****************************************************************************************************************************/

#include <Wire.h>
#include <MPU6050.h>
MPU6050 mpu;

float elapsedTime, timee, timePrev;        //Variables for time control

// Pitch, Roll and Yaw values
float pitch = 0;
float roll = 0;
float yaw = 0;


#include "defines.h"
#include "arduino_secrets.h"

// To eliminate FW warning when using not latest nina-fw version
// To use whenever WiFi101-FirmwareUpdater-Plugin is not sync'ed with nina-fw version
#define WIFI_FIRMWARE_LATEST_VERSION        "1.4.5"

#include <SPI.h>
#include <WiFiNINA_Generic.h>

///////please enter your sensitive data in the Secret tab/arduino_secrets.h
char ssid[] = SECRET_SSID;        // your network SSID (name)
char pass[] = SECRET_PASS;        // your network password (use for WPA, or use as key for WEP), length must be 8+

int keyIndex = 0;                 // your network key Index number (needed only for WEP)

int status = WL_IDLE_STATUS;

WiFiServer server(80);

void setup()
{
  //Initialize serial and wait for port to open:
  Serial.begin(115200);


  
  while (!Serial);

  // Initialize MPU6050
  while(!mpu.begin(MPU6050_SCALE_2000DPS, MPU6050_RANGE_2G))
  {
    Serial.println("Could not find a valid MPU6050 sensor, check wiring!");
    delay(500);
  }
  // Calibrate gyroscope. The calibration must be at rest.
  // If you don't want calibrate, comment this line.
  mpu.calibrateGyro();

  // Set threshold sensivty. Default 3.
  // If you don't want use threshold, comment this line or set 0.
  mpu.setThreshold(3);



  Serial.print(F("\nStart WiFiWebServer on ")); Serial.println(BOARD_NAME);
  Serial.println(WIFININA_GENERIC_VERSION);

  // check for the WiFi module:
  if (WiFi.status() == WL_NO_MODULE)
  {
    Serial.println(F("Communication with WiFi module failed!"));
    // don't continue
    while (true);
  }

  String fv = WiFi.firmwareVersion();
  if (fv < WIFI_FIRMWARE_LATEST_VERSION)
  {
    Serial.print(F("Your current firmware NINA FW v"));
    Serial.println(fv);
    Serial.print(F("Please upgrade the firmware to NINA FW v"));
    Serial.println(WIFI_FIRMWARE_LATEST_VERSION);
  }

  // attempt to connect to Wifi network:
  while (status != WL_CONNECTED)
  {
    Serial.print(F("Attempting to connect to SSID: "));
    Serial.println(ssid);
    // Connect to WPA/WPA2 network. Change this line if using open or WEP network:
    status = WiFi.begin(ssid, pass);

    // wait 10 seconds for connection:
    //delay(10000);
  }

  server.begin();
  // you're connected now, so print out the status:
  printWiFiStatus();
  timee = millis();
}

void loop()
{
  timePrev = timee;
  

  // listen for incoming clients
  WiFiClient client = server.available();
  if (client)
  {
    Serial.println(F("New client"));
    // an http request ends with a blank line
    boolean currentLineIsBlank = true;
    
    while (client.connected()) 
    {
      if (client.available()) 
      {
        char c = client.read();
        Serial.write(c);
        // if you've gotten to the end of the line (received a newline
        // character) and the line is blank, the http request has ended,
        // so you can send a reply
        if (c == '\n' && currentLineIsBlank) 
        {
          // send a standard http response header
          client.println("HTTP/1.1 200 OK");
          client.println("Content-Type: text/html");
          client.println("Connection: close");  // the connection will be closed after completion of the response
          client.println("Refresh: 1");  // refresh the page automatically every 5 sec
          client.println();
          client.println("<!DOCTYPE HTML>");
          client.println("<html>");

          timee = millis();                        // actual time read
          elapsedTime = (timee - timePrev) / 1000; //divide by 1000 in order to obtain seconds 
          // Read normalized values
          Vector norm = mpu.readNormalizeGyro();
        
          // Calculate Pitch, Roll and Yaw
          pitch = pitch + norm.YAxis * elapsedTime;
          roll = roll + norm.XAxis * elapsedTime;
          yaw = yaw + norm.ZAxis * elapsedTime;
          
          
          // output the value of pitch roll yaw
          client.print("Pitch: ");
          client.print(pitch);
          client.print("     ");
          client.print("Roll: ");
          client.print(roll);
          client.print("     ");
          client.print("Yaw: ");
          client.print(yaw);
          client.println("<br />");
          
          
          client.print("thanks for working");
          
          client.println("</html>");
          break;
        }
        
        if (c == '\n') 
        {
          // you're starting a new line
          currentLineIsBlank = true;
        } 
        else if (c != '\r') 
        {
          // you've gotten a character on the current line
          currentLineIsBlank = false;
        }
      }
    }
    // give the web browser time to receive the data
    delay(1);

    // close the connection:
    client.stop();
    Serial.println(F("Client disconnected"));
  }
}

void printWiFiStatus() 
{
  // print the SSID of the network you're attached to:
  Serial.print(F("SSID: "));
  Serial.println(WiFi.SSID());

  // print your board's IP address:
  IPAddress ip = WiFi.localIP();
  Serial.print(F("IP Address: "));
  Serial.println(ip);

  // print the received signal strength:
  long rssi = WiFi.RSSI();
  Serial.print(F("Signal strength (RSSI):"));
  Serial.print(rssi);
  Serial.println(F(" dBm"));
}
