dylanballback/CubeSat_Attitude_Control/Software/Wireless Communincation/Raspberry Pi & Arduino Com/Serial Communication/Basic_serial_from_arduino_test.py

#Refrenenced https://roboticsbackend.com/raspberry-pi-arduino-serial-communication/

#!/usr/bin/env python3
import serial
import time

if __name__ == '__main__':
    ser = serial.Serial('/dev/ttyACM0', 112500, timeout=1)
    ser.reset_input_buffer()
    
    """
    #Basic reading serial data from arduino and printing it

    while True:
        if ser.in_waiting > 0:
            line = ser.readline().decode('utf-8').rstrip()
            print(line)
    """

    # Sending arduino data and then having the arduino send back same data
    # and printing the data from arduino that was originally sent from the pi
    while True:
        ser.write(b"Turn motor left!\n")
        line = ser.readline().decode('utf-8').rstrip()
        print(line)
        time.sleep(1)


            
