dylanballback/CubeSat_Attitude_Control/(commit log)

2022-02-09 1DoF Basic Motor Code
2022-02-11 Updated PID attemps and read me
2022-02-11 updated PID code
2022-02-11 got PID V3 working!!!!
2022-02-16 update readme/pid code and testing
2022-02-19 Attempt 8 and 9 PID balance
2022-02-23 update cad
    [1U CubeSat v5.ipt]
2022-02-26 Arduino to RaspberryPI Serial Communication Test
2022-02-26 updated basic serial pi arduino code
2022-02-27 update code for PID
2022-02-27 update new pid code
2022-03-25 upload cubesat cad
2022-03-28 update filestructure added socket code
    [1U CubeSat v5.ipt]
