dylanballback/CubeSat_Attitude_Control/Images/cubesat_hardware/front_cubesat_monutV2.JPG

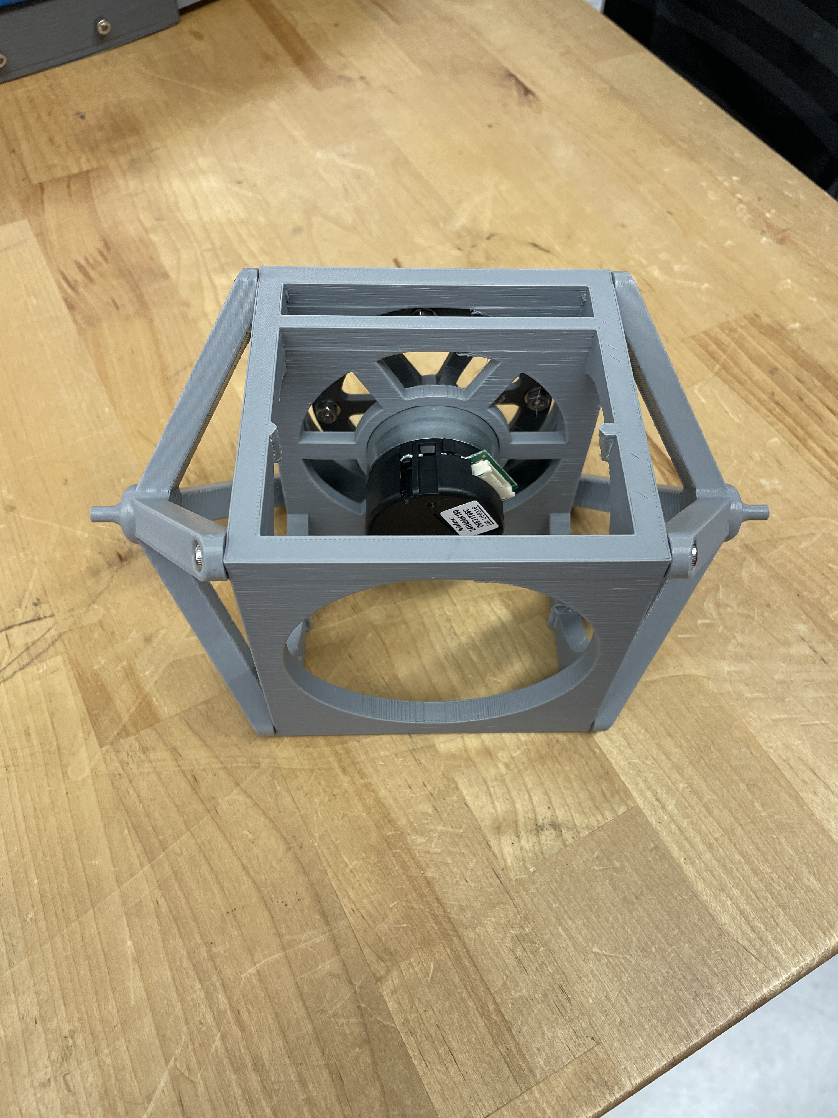
[picture p16: Images/cubesat_hardware/front_cubesat_monutV2.JPG]
Images/cubesat_hardware/front_cubesat_monutV2.JPG
