dylanballback/CubeSat_Attitude_Control/Images/cubesat_hardware/side_cubesat_monutV2.JPG

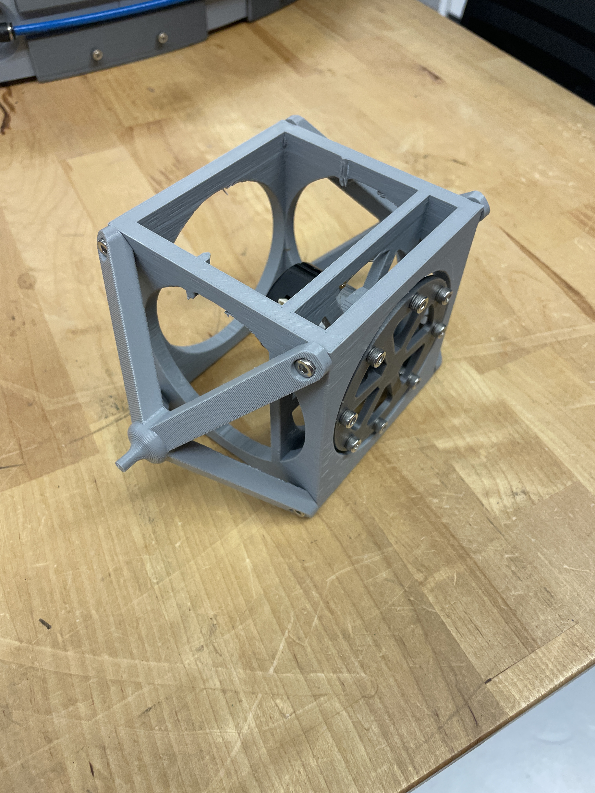
[picture p17: Images/cubesat_hardware/side_cubesat_monutV2.JPG]
Images/cubesat_hardware/side_cubesat_monutV2.JPG
