dylanballback/CubeSat_Attitude_Control/Images/cubesat_hardware/side_cubesat_gimbal_V2.JPG

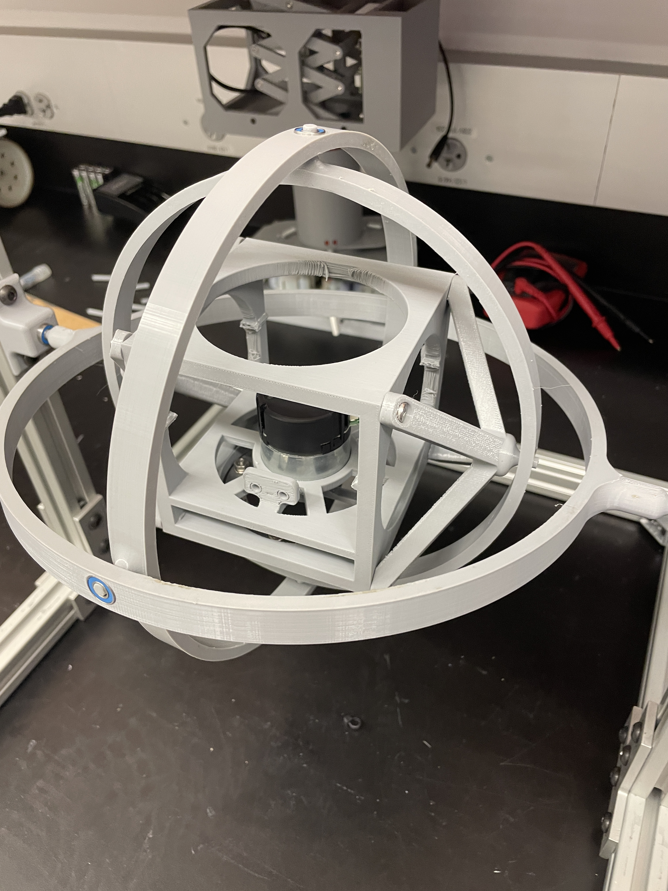
[picture p18: Images/cubesat_hardware/side_cubesat_gimbal_V2.JPG]
Images/cubesat_hardware/side_cubesat_gimbal_V2.JPG
